abicelis/ElectronicLoad/(list of files, drawings)

Other design files:
Schematic/ElectronicLoad.pdsprj
