abicelis/ElectronicLoad/(commit log)

2016-12-09 Created BOM in Readme.md
2016-12-09 Worked on Schematic, added Screenshot into Schematic.png
    [ElectronicLoad.pdsprj]
2016-12-09 Included Schematic.png into Readme.md
2016-12-12 BUGFIX Eliminated pinMode(INPUT_PULLUP, ...), crashed the encoder code.
    [ElectronicLoadController.ino]
2016-12-12 Major changes Implemented Triangls Wave Variable Current Mode Renamed files, rearranged files and functions
2016-12-12 Sine wave variable current mode added!!
2020-03-02 Modified the LCD wiring a bit
2020-03-02 Fixed encoder decrement bug on Constant Resistance and Constant Power mode
    [ElectronicLoadController.ino]
2020-03-10 Removed OutputEnabledPin, that LED is now directly connected to ISetPin to more accurately display ISet, and to save a pin!
2020-03-14 Lots of fixes/improvements:
    Added tweak values for VLoad and ILoad.
    Added acceleration to encoder.
    Cleaned up the code a bit.
    Improved latency, deleted a bunch of delay() calls.
    [ElectronicLoadController.ino, eeprom.h, pwm16Bit.h, values.h]
2020-03-15 Main code rewrite, mostly to update it to use the encoder with acceleration code, also added custom intervals for sampling / updating lcd / fan
2020-03-15 Temperature sampling controls Fan speed via PWM while also checking for overtemp and disabling output
2020-03-15 Enable on overtemp bugfix
    [ElectronicLoadController.ino, eeprom.h]
2020-06-08 Switched LCD pins to rev1.0
2020-06-08 Commented out debug print
2020-06-08 Inverted encoder logic, PCB rev1.0 has irs encoder placed upside down!
    [userActions.h]
2020-06-08 Switched encoder pins in software instead of inverting the logic
    [userActions.h, values.h]
2020-06-09 Tweaked the fan behaviour a bit
